WeSpeakEnglish/MCU_LDO/(commit log)

2026-10-22 schematic and sketch added
2026-10-23 Update U2 LDO specification from 3.3V to 5V
2026-10-23 schematic on 5V
2026-10-23 Simplify calibration instructions in README
    Removed redundant steps in calibration instructions and clarified the correction note.
